canertol/teleoperated_robot/Codes/CircleDetection/sample.jpg

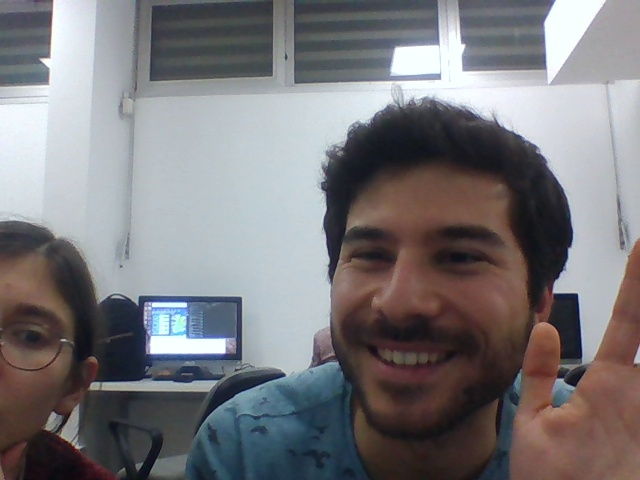
Codes/CircleDetection/sample.jpg
