canertol/teleoperated_robot/README.md

# Poro-Inc.
Where dreams come true.
EE493-494, 2018-2019.

Watch our demo video of the first prototype:
https://youtu.be/LAClyT0ZEu4
