canertol/teleoperated_robot/Codes/arduino_code/arduino_code_speed_controlled/arduino_code_speed_controlled.ino

#define PI 3.1415926535897932384626433832795
// defines sensor pin numbers
const int trigPin1 = 32;
const int echoPin1 = 33;
const int trigPin2 = 34;
const int echoPin2 = 35;
const int trigPin3 = 36;
const int echoPin3 = 37;
const int trigPin4 = 38;
const int echoPin4 = 39;
// define motor pin numbers
const int m1a = 22;
const int m1b = 23;
const int m2a = 24;
const int m2b = 25;
const int m3a = 26;
const int m3b = 27;
const int m4a = 28;
const int m4b = 29;
const int pwm1 = 2;
const int pwm2 = 3;
const int pwm3 = 4;
const int pwm4 = 5;
// define kicker pin number
const int kick = 42;
// define dribble pin number
const int drib = 7;
// define dribble enable pin number
const int driben1 = 50;
const int driben2 = 51;

// defines variables
long duration1;
long duration2;
long duration3;
long duration4;
int distance1;
int distance2;
int distance3;
int distance4;
int prev1 = 0;
int prev2 = 0;
int prev3 = 0;
int prev4 = 0;
int a,b;
int raspberry_out[2];
int theta = -1;
int mag = -1;
int ind = -1;
int index = -1;
int value = -1;
int threshold = 5;
int prevMSG = -1;
int MSG = 0;

void setup() {
  // put your setup code here, to run once:
  Serial.begin(9600);
  pinMode(trigPin1, OUTPUT); // Sets the trigPin as an Output
  pinMode(trigPin2, OUTPUT);
  pinMode(trigPin3, OUTPUT);
  pinMode(trigPin4, OUTPUT);
  
  pinMode(echoPin1, INPUT); // Sets the echoPin as an Input
  pinMode(echoPin2, INPUT);
  pinMode(echoPin3, INPUT);
  pinMode(echoPin4, INPUT);

  pinMode(m1a, OUTPUT); // Sets motor pins as Output
  pinMode(m1b, OUTPUT);
  pinMode(m2a, OUTPUT);
  pinMode(m2b, OUTPUT);
  pinMode(m3a, OUTPUT);
  pinMode(m3b, OUTPUT);
  pinMode(m4a, OUTPUT);
  pinMode(m4b, OUTPUT);

  //pinMode(drib, OUTPUT); // Sets dribble pin as Output
  pinMode(driben1, OUTPUT);
  pinMode(driben2, OUTPUT);

  pinMode(kick, OUTPUT); // Set kicker pin as Output  
  //pinMode(pwm1, OUTPUT);
  //pinMode(pwm2, OUTPUT);
  //pinMode(pwm3, OUTPUT);
  //pinMode(pwm4, OUTPUT);
}

void loop() { 
  // put your main code here, to run repeatedly:
  int data = 0;
  int stick_data = 0;
  // set dribble input pins

  // send sensor data
  sensors(trigPin1,trigPin2,trigPin3, trigPin4, echoPin1, echoPin2, echoPin3, echoPin4 );
 
  while (Serial.available() > 0)
  {
    //analogWrite(pwm1, 50);
    //analogWrite(pwm2, 50);
    //analogWrite(pwm3, 50);
    //analogWrite(pwm4, 50);

    int pwm11 = 255;
    int pwm22 = 255;
    int pwm33 = 255;
    int pwm44 = 255;
    int pwm11s = 150;
    int pwm22s = 150;
    int pwm33s = 150;
    int pwm44s = 150;

    data = Serial.read();

    if(ind < 0){
      ind = (int)data; //indicator, first element of data
      continue;
    }
    
   // data = int(data);
   // Serial.println(data);
   
    if(ind == 1 || ind == 0){
      
      if(theta < 0){
      theta = (int)data;
      //Serial.println(theta);
      continue;
      }

      if(mag < 0){
      mag = (int)data;
      //Serial.println(mag);
      }
    }
    
    if(ind == 2){
      if(index < 0){
      index = (int)data;
      //Serial.println(index);
      continue;
      }

      if(value < 0){
      value = (int)data;
      //Serial.println(value);
      }

      if( index == 6 ){
          if (value == 1){
            digitalWrite( driben1, HIGH); 
            digitalWrite( driben2, LOW);
            analogWrite( drib, 150);
          }
          else if (value == 0)
            analogWrite( drib, 0);
      }
      if( index == 4 ){
          if (value == 1){
            digitalWrite( driben1, LOW); 
            digitalWrite( driben2, HIGH);
            analogWrite( drib, 150);
          }
          else if (value == 0){
            analogWrite( drib, 0);
            }
      }
      else if (index == 7){
          if (value == 1){
            digitalWrite( kick, HIGH);
            //Serial.println("high");
            }
          else if (value == 0){
            digitalWrite( kick, LOW);
            //Serial.println("low");
            }            
        }
    }    
    //Serial.println(ind);
    //Serial.println(index);
    //Serial.println(value);
    
    if(ind == 0)
       stick_data = acibolge(theta, mag);
       //Serial.write(stick_data); 
    else if(ind == 1){
       theta = (theta * 2 * PI) / 127; // convert into the RAD        
       if (abs(mag*cos(theta))<50)
        stick_data = 0;
       else if(mag * cos(theta) > 87){
        stick_data = 10;
        }
       else if(mag * cos(theta) > 50 && mag * cos(theta) < 87){
        stick_data = 20;
       } 
       else if(mag * cos(theta) < -85){
        stick_data = 5;
        }
       else if(mag * cos(theta) < -50 && mag * cos(theta) > -85){
        stick_data = 15;
        } 
       else if(mag * sin(theta) > 85){
        stick_data = 0;
       }
       else if(mag * sin(theta) < -80){
        stick_data = 0;      
       }
    }
        
    if (stick_data == 1)
    { 
      analogWrite(pwm1, pwm11);
      analogWrite(pwm2, pwm22);
      analogWrite(pwm3, pwm33);
      analogWrite(pwm4, pwm44);
      digitalWrite(m1a, LOW);
      digitalWrite(m1b, LOW);
      digitalWrite(m2a, LOW);
      digitalWrite(m2b, HIGH);
      digitalWrite(m3a, LOW);
      digitalWrite(m3b, LOW);
      digitalWrite(m4a, HIGH);
      digitalWrite(m4b, LOW);
    }

    if (stick_data == 11)
    { 
      analogWrite(pwm1, pwm11s);
      analogWrite(pwm2, pwm22s);
      analogWrite(pwm3, pwm33s);
      analogWrite(pwm4, pwm44s);
      digitalWrite(m1a, LOW);
      digitalWrite(m1b, LOW);
      digitalWrite(m2a, LOW);
      digitalWrite(m2b, HIGH);
      digitalWrite(m3a, LOW);
      digitalWrite(m3b, LOW);
      digitalWrite(m4a, HIGH);
      digitalWrite(m4b, LOW);
    }
    
    if (stick_data == 2)
    {
      analogWrite(pwm1, pwm11);
      analogWrite(pwm2, pwm22);
      analogWrite(pwm3, pwm33);
      analogWrite(pwm4, pwm44);
      digitalWrite(m1a, HIGH);
      digitalWrite(m1b, LOW);
      digitalWrite(m2a, LOW);
      digitalWrite(m2b, HIGH);
      digitalWrite(m3a, LOW);
      digitalWrite(m3b, HIGH);
      digitalWrite(m4a, HIGH);
      digitalWrite(m4b, LOW);
    }  

    if (stick_data == 12)
    {
      analogWrite(pwm1, pwm11s);
      analogWrite(pwm2, pwm22s);
      analogWrite(pwm3, pwm33s);
      analogWrite(pwm4, pwm44s);
      digitalWrite(m1a, HIGH);
      digitalWrite(m1b, LOW);
      digitalWrite(m2a, LOW);
      digitalWrite(m2b, HIGH);
      digitalWrite(m3a, LOW);
      digitalWrite(m3b, HIGH);
      digitalWrite(m4a, HIGH);
      digitalWrite(m4b, LOW);
    }  
    
    if (stick_data == 3)
    {
      analogWrite(pwm1, pwm11);
      analogWrite(pwm2, pwm22);
      analogWrite(pwm3, pwm33);
      analogWrite(pwm4, pwm44);
      digitalWrite(m1a, HIGH);
      digitalWrite(m1b, LOW);
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
  delayMicroseconds(10);
  digitalWrite(trigPin2, LOW);
  duration2 = pulseIn(echoPin2, HIGH);
  delay(30);
  digitalWrite(trigPin3, HIGH);
  delayMicroseconds(10);
  digitalWrite(trigPin3, LOW);
  duration3 = pulseIn(echoPin3, HIGH);
  delay(30);
  digitalWrite(trigPin4, HIGH);
  delayMicroseconds(10);
  digitalWrite(trigPin4, LOW);
  duration4 = pulseIn(echoPin4, HIGH);
  delay(30);
  // Calculating the distance
  distance1 = duration1*0.034/2;
  distance2 = duration2*0.034/2;
  distance3 = duration3*0.034/2;
  distance4 = duration4*0.034/2;
  
  if(distance1 < threshold && MSG != prevMSG){
    MSG = 1;
    Serial.write("1");
    prevMSG = MSG;}
  if(distance2 < threshold && MSG != prevMSG){
    MSG = 2;
    Serial.write("2");
    prevMSG = MSG;}
  if(distance3 < threshold && MSG != prevMSG){
    MSG = 3;
    Serial.write("3");
    prevMSG = MSG;}
  if(distance4 < threshold && MSG != prevMSG){
    MSG = 4;
    Serial.write("4");
    prevMSG = MSG;}
 /* if( distance1 > threshold && distance2 > threshold && distance3 > threshold && distance4 > threshold && MSG != prevMSG){
    MSG = 0;
    Serial.write("0");
    prevMSG = MSG;
  }*/
  MSG = -1;
 /* 
  int delta1 = abs(distance1 - prev1);
  int delta2 = abs(distance2 - prev2);
  int delta3 = abs(distance3 - prev3);
  int delta4 = abs(distance4 - prev4);
 
  if(delta1>2 || delta2>2 || delta3>2 || delta4>2 ){
    //Serial.print("Distance4: ");
    //Serial.println(distance4);
    //Serial.write(distance1);
    //Serial.write(distance2);
    //Serial.write(distance3);
    //Serial.write(distance4);
  }
  
    prev1 = distance1;
    prev2 = distance2;
    prev3 = distance3;
    prev4 = distance4;
  */
    return 0;
}
